Nicolas-Torres/DO_PH_TMP_Sensor_SIM7000G_HyM/Imagenes/test.jpeg

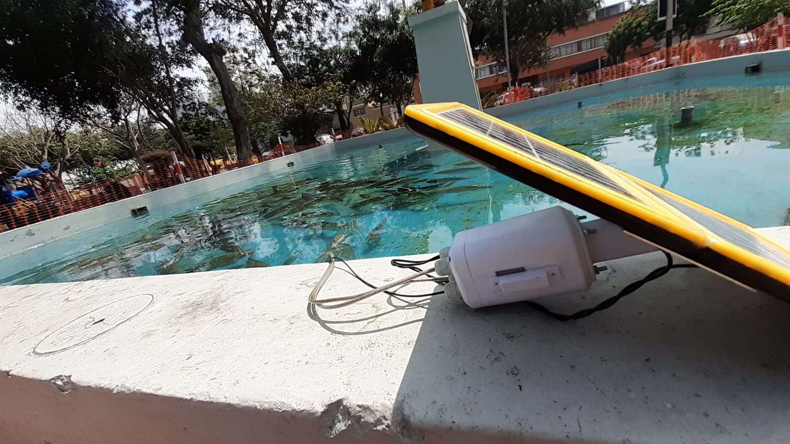
Imagenes/test.jpeg
