Nicolas-Torres/DO_PH_TMP_Sensor_SIM7000G_HyM/Imagenes/COMANDOS AT.jpg

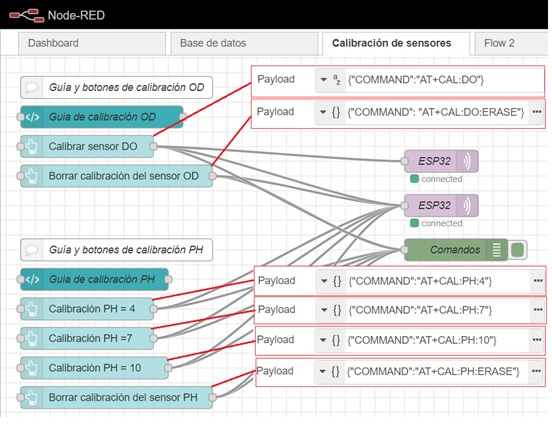
Imagenes/COMANDOS AT.jpg
