Nicolas-Torres/DO_PH_TMP_Sensor_SIM7000G_HyM/Hardware/Sensores/Info.docx

Sensores:

1. Oxigeno: Gravity™ Analog Dissolved Oxygen Kit

https://atlas-scientific.com/gravity-analog-do-kit/

2. pH: Gravity™ Analog pH Kit

https://atlas-scientific.com/gravity-analog-ph-kit/

3. Temperatura: DS18B20

https://datasheets.maximintegrated.com/en/ds/DS18B20.pdf

Dispositivo: LILYGO®Módulo de T-SIM7000G TTGO, ESP32-WROVER-B, Chip, WiFi, Bluetooth 18650, soporte de batería, placa de carga Solar

https://es.aliexpress.com/item/4000542688096.html

github:

https://github.com/Xinyuan-LilyGO/LilyGO-T-SIM7000G
