Nicolas-Torres/DO_PH_TMP_Sensor_SIM7000G_HyM/Hardware/DO(%) to DO(ppm).xlsx

P (atm): | 1.00181
 |  |  |  | DOin(%) =
H2O Temp. |  | Cp | ppm | 96.57
(deg C) |  | (mg/L)
0 |  | 14.6518
5 |  | 12.7916
10 |  | 11.3105
22.6 |  | 8.6607
20.21 |  | 9.0741 | 8.7629
100 |  | 2.2854
28 |  | 7.8393
35 |  | 6.9609
