Nicolas-Torres/DO_PH_TMP_Sensor_SIM7000G_HyM/Documentos/Copia de topologia de Protocolo  walter.png

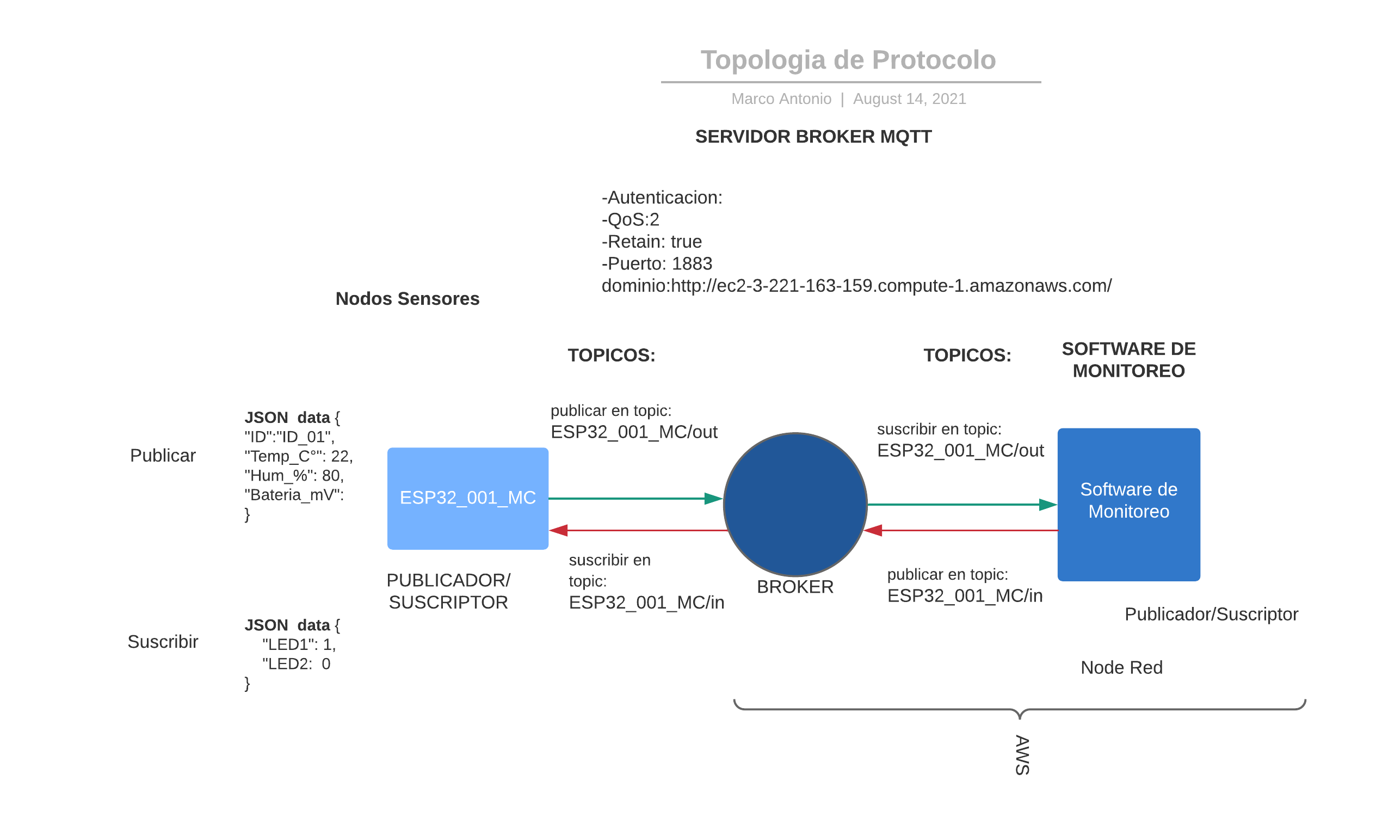
Documentos/Copia de topologia de Protocolo walter.png
