Nicolas-Torres/DO_PH_TMP_Sensor_SIM7000G_HyM/Imagenes/01 Dashboard.png

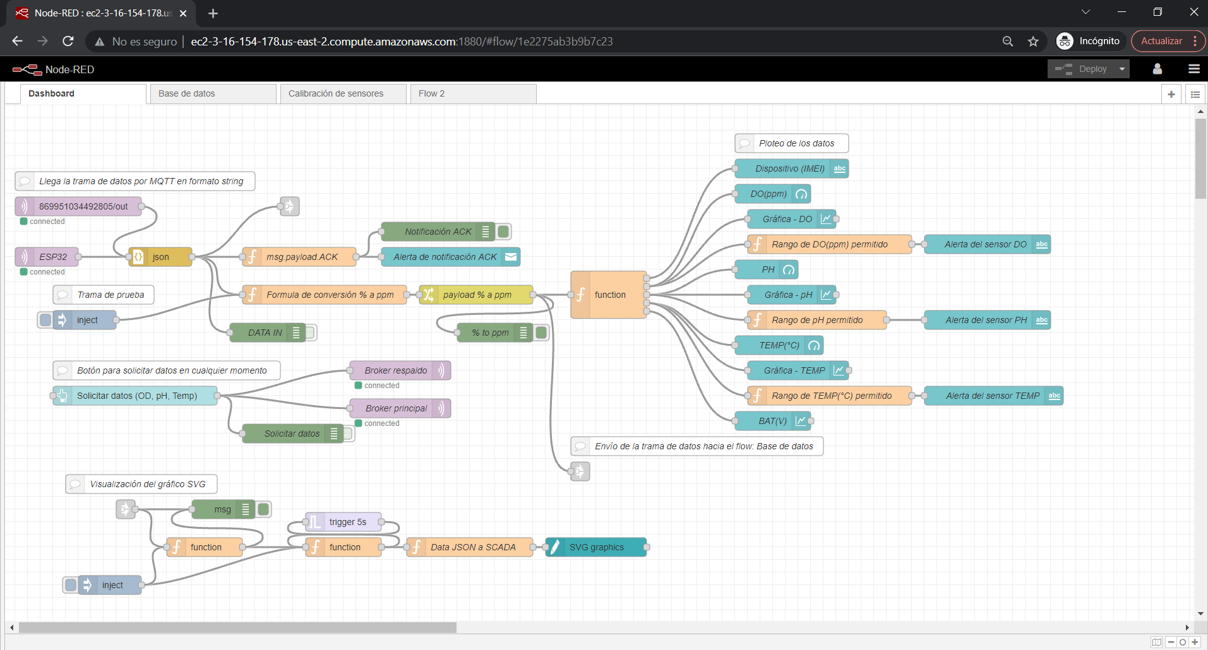
Imagenes/01 Dashboard.png
