Nicolas-Torres/DO_PH_TMP_Sensor_SIM7000G_HyM/Imagenes/02 Base de datos.png

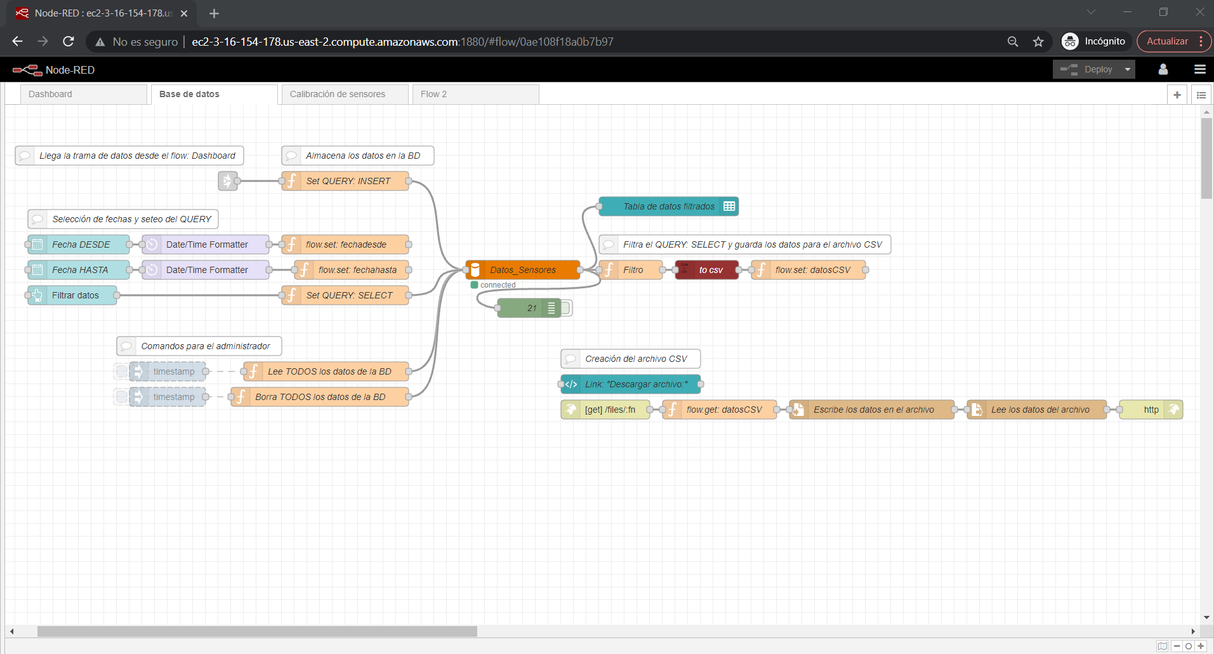
Imagenes/02 Base de datos.png
