Nicolas-Torres/DO_PH_TMP_Sensor_SIM7000G_HyM/Imagenes/05 phpmyadmin.png

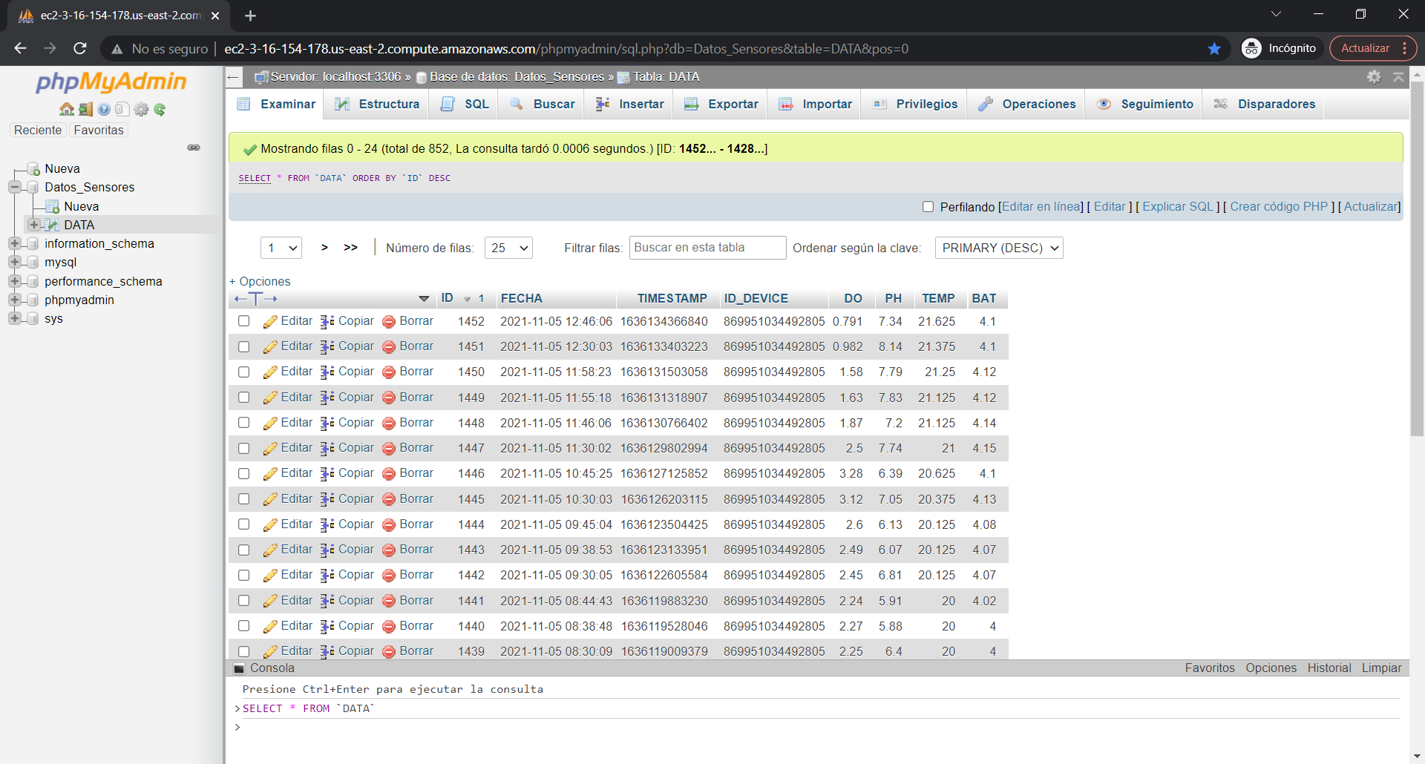
Imagenes/05 phpmyadmin.png
