Nicolas-Torres/DO_PH_TMP_Sensor_SIM7000G_HyM/Imagenes/06 phpmyadmin2.png

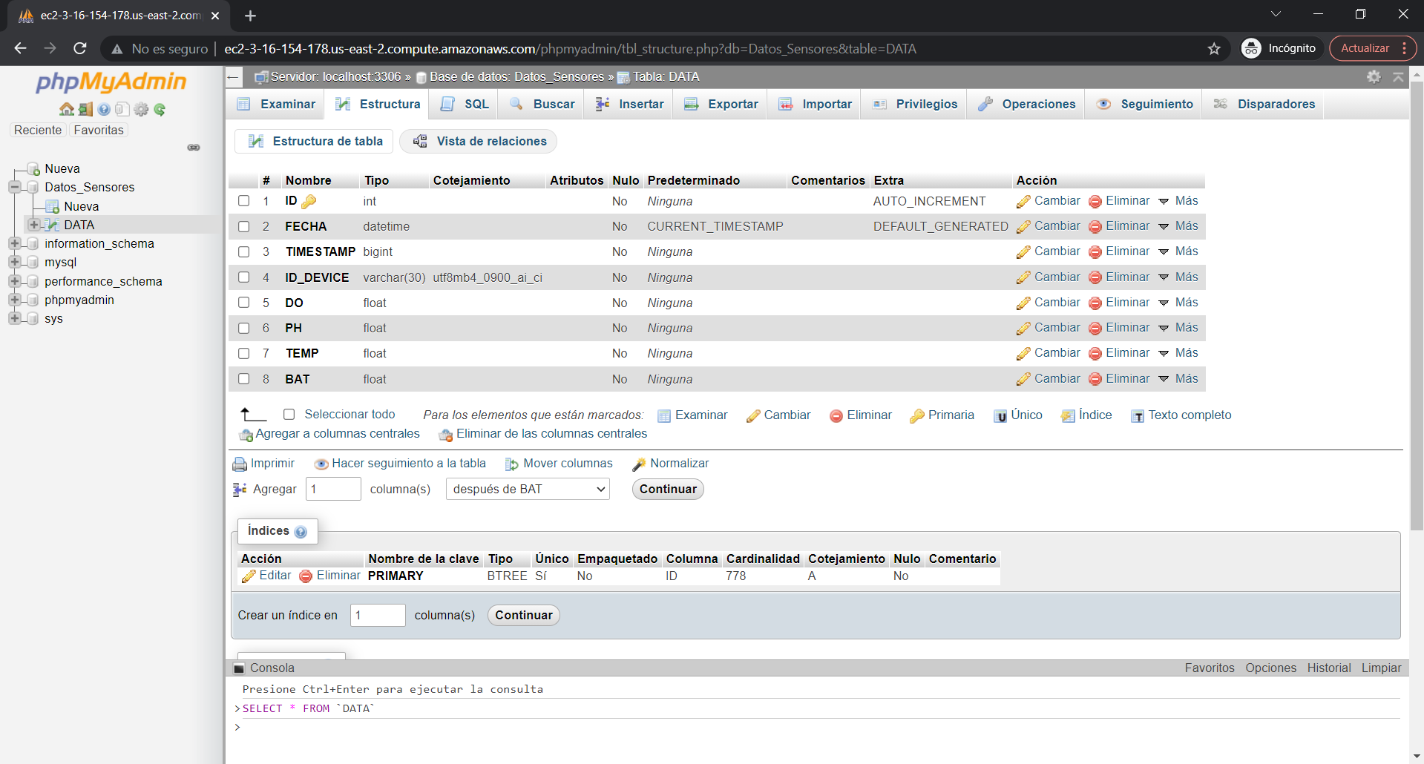
Imagenes/06 phpmyadmin2.png
