Nicolas-Torres/DO_PH_TMP_Sensor_SIM7000G_HyM/Imagenes/En operacion 2.png

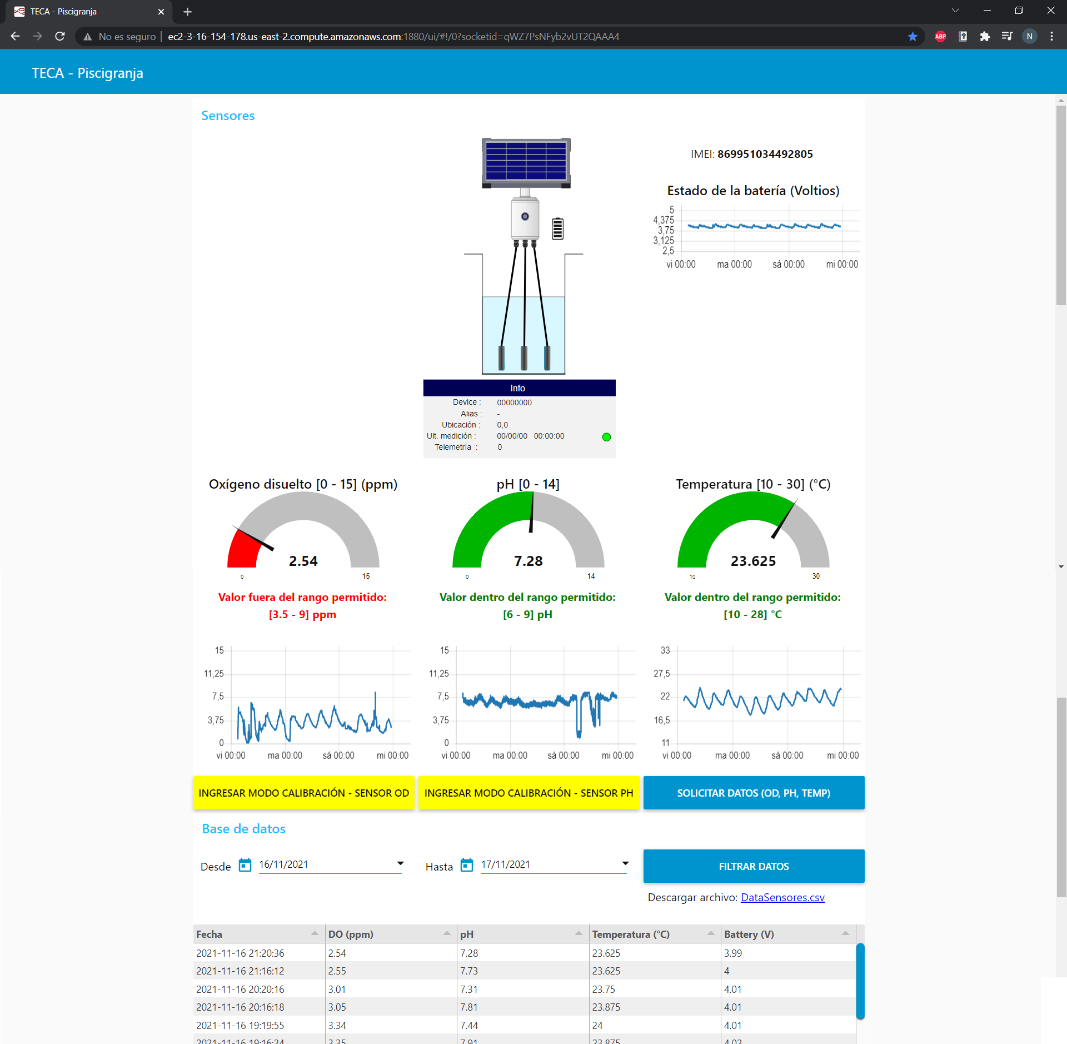
Imagenes/En operacion 2.png
