Nicolas-Torres/DO_PH_TMP_Sensor_SIM7000G_HyM/Imagenes/En operacion.png

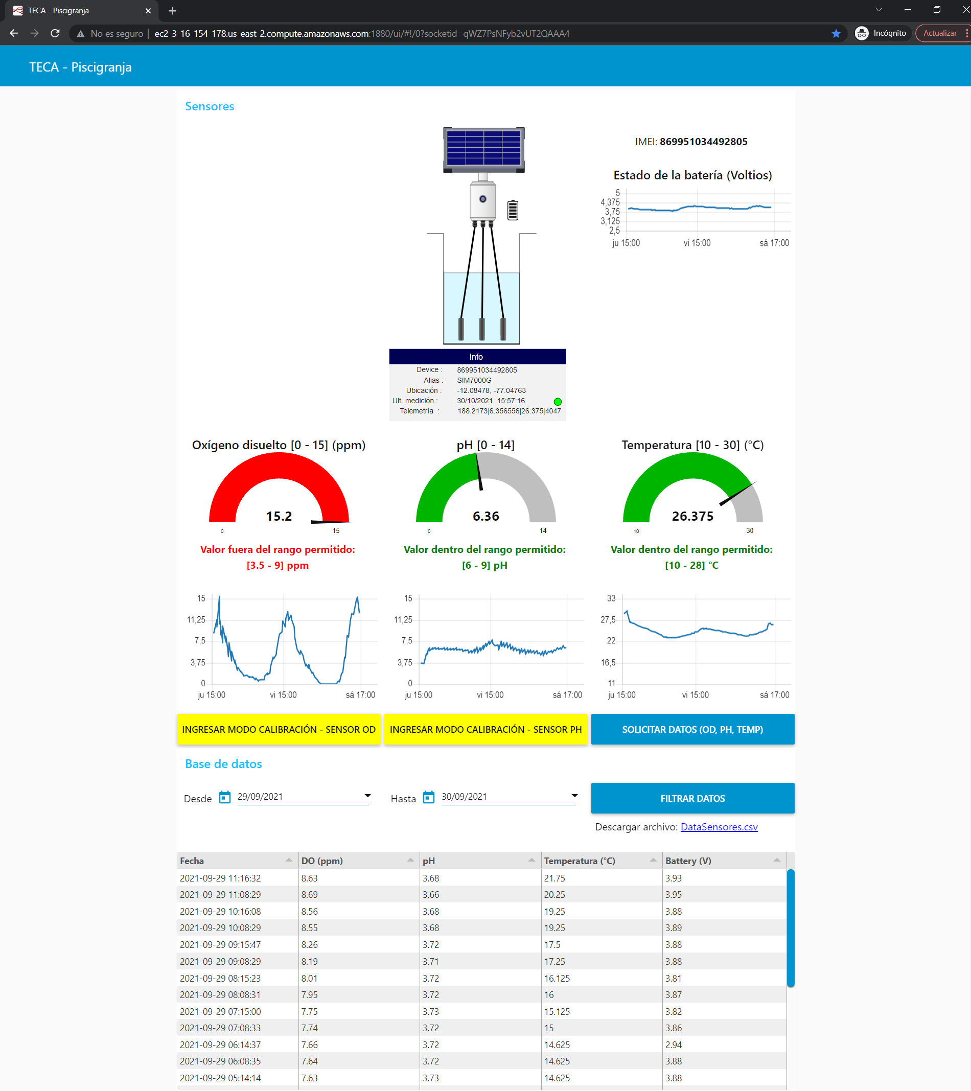
Imagenes/En operacion.png
