Nicolas-Torres/DO_PH_TMP_Sensor_SIM7000G_HyM/Imagenes/Puesta en marcha.jpg

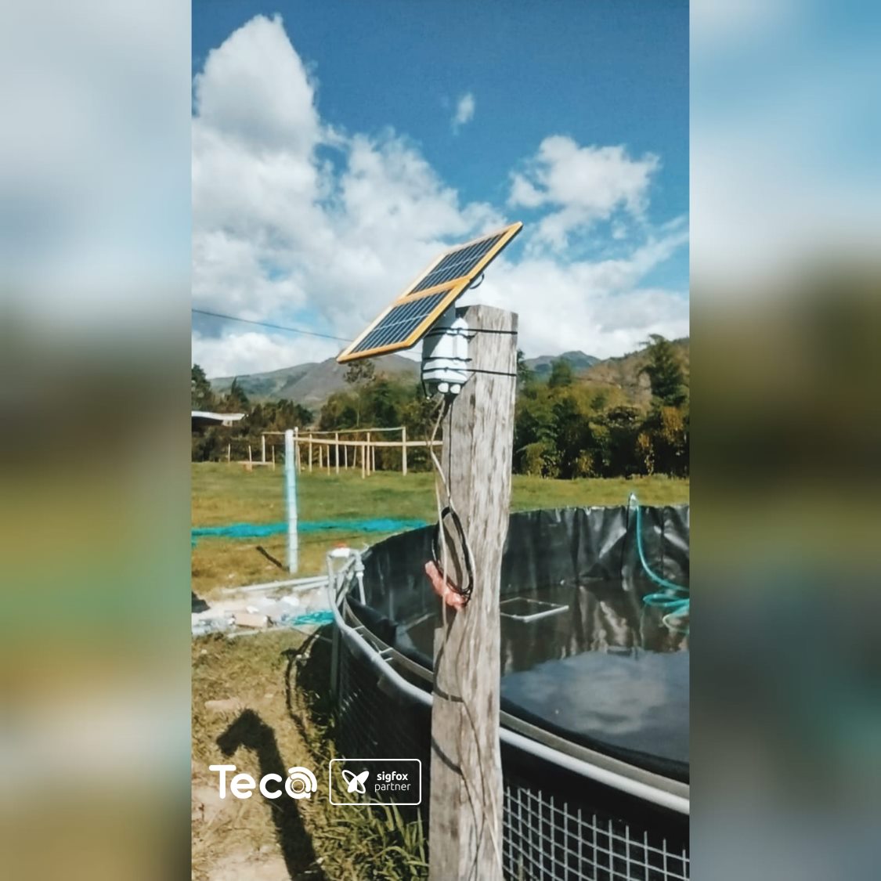
Imagenes/Puesta en marcha.jpg
