Nicolas-Torres/DO_PH_TMP_Sensor_SIM7000G_HyM/Imagenes/SVG/panel.png

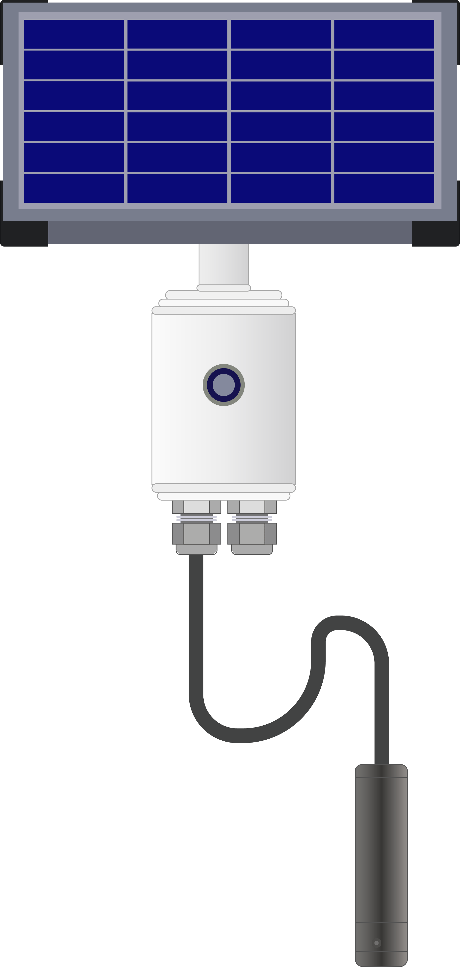
Imagenes/SVG/panel.png
