Nicolas-Torres/DO_PH_TMP_Sensor_SIM7000G_HyM/Imagenes/03 Calibración de sensores.png

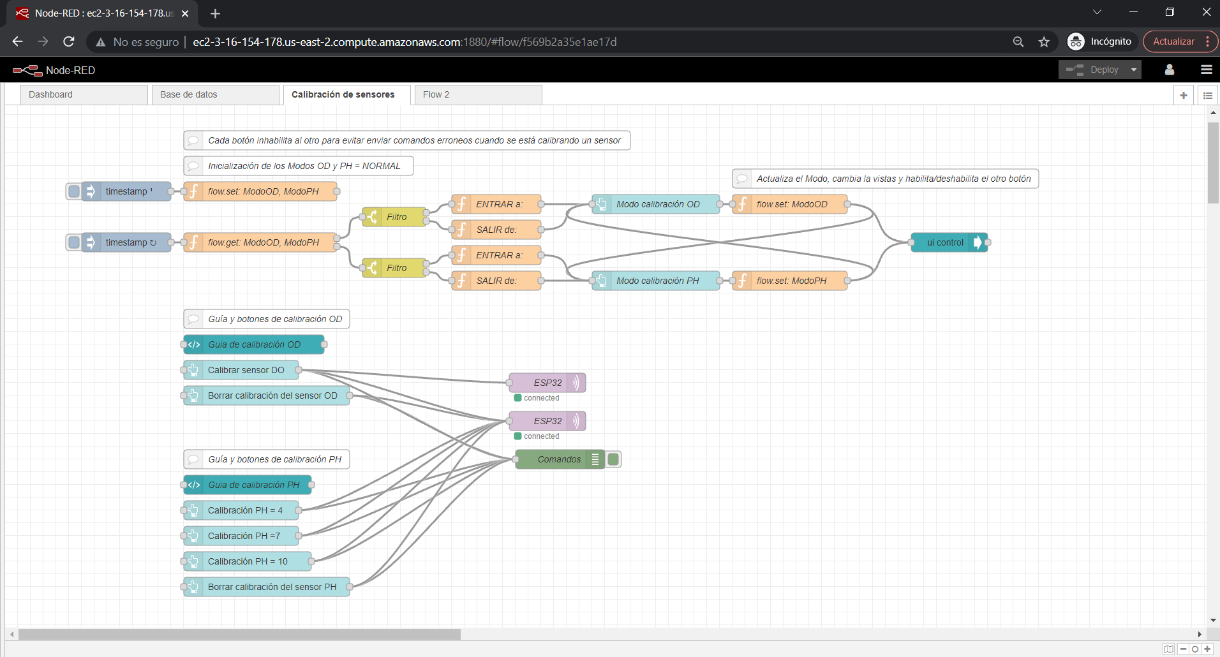
Imagenes/03 Calibración de sensores.png
