Nicolas-Torres/DO_PH_TMP_Sensor_SIM7000G_HyM/Imagenes/04 Debug.png

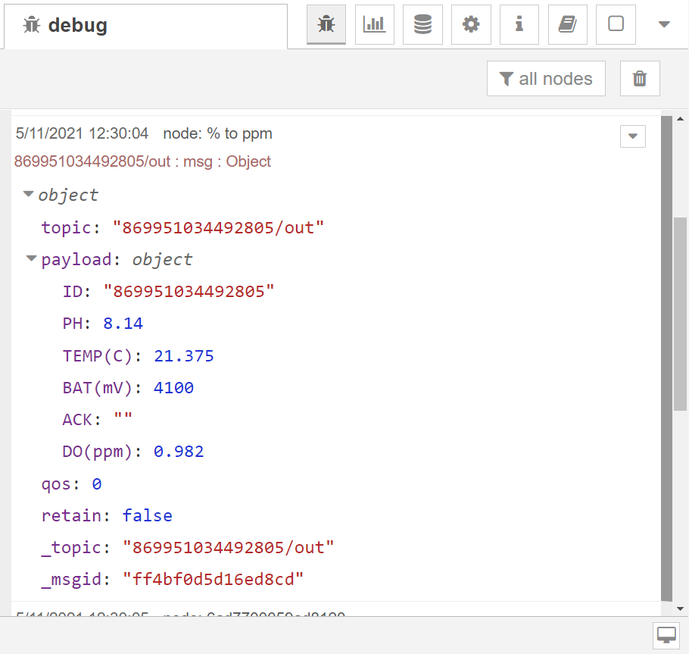
Imagenes/04 Debug.png
