Nicolas-Torres/DO_PH_TMP_Sensor_SIM7000G_HyM/Hardware/atlas_gravity/do_grav.h

/*
MIT License

Copyright (c) 2020 Atlas Scientific

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
THE SOFTWARE IS PROVIDED "AS IS", WITHOUT WARRANTY OF ANY KIND, EXPRESS OR
IMPLIED, INCLUDING BUT NOT LIMITED TO THE WARRANTIES OF MERCHANTABILITY,
FITNESS FOR A PARTICULAR PURPOSE AND NONINFRINGEMENT. IN NO EVENT SHALL THE
AUTHORS OR COPYRIGHT HOLDERS BE LIABLE FOR ANY CLAIM, DAMAGES OR OTHER
LIABILITY, WHETHER IN AN ACTION OF CONTRACT, TORT OR OTHERWISE, ARISING FROM,
OUT OF OR IN CONNECTION WITH THE SOFTWARE OR THE USE OR OTHER DEALINGS IN THE
SOFTWARE
*/

#ifndef DO_GRAV_H
#define DO_GRAV_H

#include "Arduino.h"
//#include "WProgram.h"

#include <base_grav.h>

#define DEFAULT_SAT_VOLTAGE_CONST (40.0*11.0)

class Gravity_DO : public Gravity_Base{
	public:
	
		Gravity_DO(uint8_t pin);
		
		bool begin();
	
		virtual float read_voltage();
		float read_do_percentage(float voltage_mV);
		float read_do_percentage();
        
        float cal();
        float cal_clear();
        
    protected:
		static const int volt_avg_len = 1000;
	private:
		
        const float DEFAULT_SAT_VOLTAGE = DEFAULT_SAT_VOLTAGE_CONST;
		struct DO {
		  const uint8_t magic = magic_char;
          const enum grav_type type = GRAV_DO;
		  float full_sat_voltage = DEFAULT_SAT_VOLTAGE_CONST;
		};
		struct DO Do;
};

#endif
