Nicolas-Torres/DO_PH_TMP_Sensor_SIM7000G_HyM/(commit log)

2022-09-12 Actualizo documentacion
    [DO(%) to DO(ppm).xlsx]
2022-09-12 se actualiza documentos
    [DO(%) to DO(ppm).xlsx]
2022-09-12 se actualiza documentacion
    [DO(%) to DO(ppm).xlsx]
